umastrings/26_HA018/docs/hanium_인터페이스_확정현황.md

# 인터페이스 확정 현황

> 팀 간 접점(프로토콜·치수·극성·포트)이 지금 어디까지 정해졌는지 한곳에 모은 문서.
> **"이거 정해졌나?" 싶을 때 여기부터 보면 된다.**
> 최종 갱신: 2026-08-15 (구동계 실측값 8/13 반영)

---

## ✅ 확정된 것

| 항목 | 값 | 근거 |
|---|---|---|
| **시리얼 프로토콜** | `<E,c1..c4>` 25Hz / `<M,pwm1..4>` −255~255 50Hz | 핸드오프 §2 ↔ 펌웨어 일치 확인 |
| 휠 순서 | M1(앞좌/FL) · M2(뒤좌/RL) · M3(뒤우/RR) · M4(앞우/FR) | 양측 동일 |
| baud | 115200 | — |
| **PWM 스케일** | 이중 적용 없음. 젯슨이 최종 PWM(−255~255)을 그대로 전송 | `QGPMaker_MotorShield.cpp` `run()` 에서 `_speed*16` 1회만 (PCA9685 12bit) |
| **펌웨어 워치독** | `CMD_TIMEOUT_MS = 300`. 코스팅 감속 곡선 기준 판정 → 300ms에 정지 확인 | `smart_upcare_uno.ino` · 8/13 실측 |
| **젯슨 워치독** | `cmd_timeout 0.3s` + `enc_timeout 0.2s` (엔코더 업링크 끊기면 폐루프 정지·적분 리셋) | 8/13 추가 |
| **속도 제어 위치** | 젯슨 (FF+PI). UNO 는 개루프, PID 없음 | 아두이노 통합 회신 §5 |
| **UNO 포트** | `/dev/ttyCH341USB0` (CH340 클론, WCH 드라이버 필요) | 아두이노 통합 회신 §6-1 |
| **모터 극성** | `wheel_sign: [-1, -1, 1, 1]` — 좌측 2바퀴(M1·M2) 배선 반대 | 8/13 실측 (구동팀 §6-2는 우측이라 했으나 실측은 좌측) |
| **엔코더 극성** | `enc_sign: [1, 1, 1, 1]` — M1·M2는 모터·엔코더 극성이 실제로 달라 분리 설계가 필요함이 확인됨 | 8/13 실측 |
| **구동 파라미터 (무부하)** | `ff_gain 15.0` · `deadband_pwm 25` · `max_wheel_omega 8.0` | 8/13 무부하 계단입력 실측 · 부하 재측정 예정 |
| **ESP32 대수** | 2대 확보 (#1 IMU+리프트 / #2 섀시폭) | 8/7 |
| **섀시 치수** | 펼침 394×492 / 축소 280×378 mm | 7/29 STEP 실측 |
| 트랙폭 / 휠베이스 | 206.99 / 192.05 mm (바퀴 축 중심 간) | 7/29 STEP 실측 |
| 휠 지름 | 80.29 mm (CAD 외경) | 7/29 STEP 실측 · 하중 보정 필요 |
| **라이다 마운트** | 전용 고정 구조물. 가변폭과 분리 → `base_link→lidar_link` 상수 | 7/27 결정 |
| 감속비 | 90:1 → CPR 4,320 pulse/rev (4320 확인) | 8/13 enc 실측 |

---

## ⏳ 아직 정해지지 않은 것

### 🔴 리프트 명령 다운링크

젯슨에서 리프트로 **"이 높이로 올려줘"** 를 보내는 패킷이 없다.
현재는 현재높이 업링크(`<I,...>` 의 `lift_mm`)만 있다.

제안 형태:

```
젯슨 → ESP32 #1    <L,target_mm>\n
    target_mm : 목표 높이 [mm]
    예)  <L,700.0>
```

젯슨 쪽은 이미 `/lift_cmd_mm` 로 목표높이를 발행 중이라, 포맷만 정해지면 바로 연결된다.
**이게 정해져야 데모 시퀀스(침상 정지 → 리프트 상승 → 회전 → 퇴출)가 완주된다.**

같이 정할 것 —

- `lift_mm` 기준면: 완전히 접힌 상태가 0인지, 다른 값인지
- 도달 판정: `lift_mm` 수렴으로 볼지, 별도 완료 신호를 둘지
- 가동 범위: 100~740mm 유지되는지

### 🟡 3D 프린트 완료 예정일

일정 역산 기준점.

---

## 📐 조립 후 (부하 상태) 재측정할 값

위 구동 파라미터는 **무부하(바퀴 공중)** 기준 8/13 실측값이다. 조립 후 부하가 걸리면 달라지므로 다시 잡는다.
절차와 도구는 [`hanium_구동계_캘리브레이션_절차_0807.md`](hanium_구동계_캘리브레이션_절차_0807.md).

| 값 | 무부하 (8/13) | 부하 상태에서 확정할 것 |
|---|---|---|
| `ff_gain` | 15.0 | 부하 시 같은 PWM에 각속도가 떨어짐 → 재측정 |
| `deadband_pwm` | 25 | 바닥 마찰 + 로봇 무게로 커짐 → 재측정 |
| `max_wheel_omega` | 8.0 | 부하 최대속도 재확인 |
| 휠 유효반경 | 0.040145 m (CAD, 🔴 미확정) | 직진 2m 실측 vs 오도메트리로 역산 |
| 트랙폭 / 휠베이스 | 206.99 / 192.05 mm (STEP) | 제자리 90°/180° 회전으로 검증 |
| `wheel_sign` / `enc_sign` | 확정 (위 ✅) | 배선을 다시 했을 때만 재확인 |

---

## 🔗 정해지면 반영되는 곳

접점이 확정될 때 어느 파일이 바뀌는지. **바꾸기 전에 상대 팀에 알린다.**

| 확정 항목 | 반영 위치 |
|---|---|
| 리프트 패킷 | `serial_protocol.py` 다운링크 추가 + `serial_bridge_node.py` `/lift_cmd_mm` 구독 |
| `lift_mm` 기준면 | `lift_tf_node.py` 의 `lift_mm_is_absolute` |
| 섀시 최종 치수 | `nav2_care.yaml` local/global footprint |
| 라이다 높이 | `smart_upcare.urdf.xacro` 의 `lidar_link` |
| 캘리브레이션 값 | `serial_bridge_node.py` 파라미터 기본값 |
| ESP32 #2 연결 | `robot_bringup.launch.py` 의 `enable_esp2` |

> `enable_esp2` 는 당분간 `false` 유지. ESP32 #2 펌웨어가 아직 없고,
> 포트 고정 경로(`by-id`/`by-path`)가 안 정해진 상태에서 켜두면 엉뚱한 장치를 열 수 있다.

---

## 미해결 기술 이슈

코드 검토에서 나온 것 중 팀 간 조율이 필요한 항목. 상세는
[`hanium_실차전_코드점검_0807.md`](hanium_실차전_코드점검_0807.md).

| 항목 | 상태 |
|---|---|
| `local_costmap` footprint 가 시뮬용 축소값(0.34×0.30)으로 남아 있음 | 실물 치수로 복원 필요 |
| `/scan_depth`(D415) 를 Nav2·Collision Monitor 가 안 씀 | 배선 미완 |
| `QGPMaker_Encoder.h` 의 `read()` 인터럽트 미보호 → 카운트 튐 가능 | 캘리브레이션에서 실측 확인 후 판단 |
