umastrings/26_HA018/docs/hanium_하드웨어_완성_로드맵_체크리스트.md

# hanium_하드웨어 완성 로드맵 체크리스트 (7/27 → 8/8)

> **작성**: 구영인 (자율주행/퍼셉션)
> **기준일**: 2026-07-27 · **하드웨어 조립 완료 목표**: 8/8 (D-12)
> **관련 문서**: `hanium_알고리즘_명세서_자율주행.md` (v1.2), `05_시뮬레이션_셋업_체크리스트.md` (v2.0), `hanium_최종결론_백업.md` (v1.2)

> **📌 7/27 갱신 — §4 ROS 파일 초안 전부 완성 (B안 재편)**
> `~/hanium_ws`에 §4 파일 전부 초안 작성·정적 검증 완료. serial_bridge를 **3-MCU + IK/FK 통합 + FF/PI 폐루프 + 300ms 워치독**으로 재편(B안). 중복된 `mecanum_ik_node`/`mecanum_odom_node`는 브리지 통합으로 삭제. `laser_filter.yaml`도 no-op 템플릿으로 선작성.
> 검증(샌드박스): 폐루프 수렴오차 0.0099 rad/s · 프로토콜 왕복 · YAML/xacro 파싱 · entry_point · 전체 컴파일 통과. **`colcon build`는 VM/젯슨에서 필요(ROS2 미설치 환경).**
> 남은 실물 의존: ①리프트 명령 다운링크(→ESP32) 프로토콜 미정 §6 ②`lift_mm` 기준면 §6 ③ESP32 대수(`enable_esp2`) ④Gazebo 스폰 롤오버·prismatic 처짐 확인.

## 오늘 확인된 것

| 항목 | 상태 |
|---|---|
| 메카넘휠 구동 | ✅ 정상 회전 확인 |
| RPLIDAR A2M12 | ✅ 젯슨 연결 → RViz2에서 LaserScan 출력 확인 |
| RealSense D415 | ✅ 젯슨 연결 → 영상 출력 확인 |
| 섀시 (7/27 CAD 공유) | 🟡 젯슨 중앙 공간 확보, 곡면 커버 수정 완료 → 3D 프린트 대기 |
| 라이다 마운트 | ✅ **전용 고정 구조물로 확정** (7/27) — 가변폭과 분리됨. 높이만 미정 |
| 가변폭 방식 | ✅ **대각선 45° 수축** — 가로·세로 델타 모두 114mm. 모서리 하나가 약 81mm 이동 |

---

## 0. 계획 점검 — 생각한 두 가지에 대한 판단

| 생각한 것 | 판단 | 이유 |
|---|---|---|
| **가상 월드 구성해서 시뮬레이션** | ⚠️ **이미 완료된 항목** | `care_facility.world`(복도 8m×1.2m + 침상 3개) 제작 + `care_map.pgm/.yaml` 저장이 7/23에 끝남. 지금 필요한 건 새 월드가 아니라 **그 월드 위에서 Collision Monitor 통합 → Nav2 재튜닝 → 데모 시퀀스 완주** |
| **하드웨어 완성 시 필요한 ROS 파일/코드 작성** | ✅ **맞음. 가장 중요** | 단, "완성 **시**"가 아니라 **지금 미리** 써야 함. 조립 끝나고 코드 시작하면 8월 말 데모 영상 마감 못 맞춤. §4 파일 목록 참고 |
| *(빠짐)* **3D 프린트 발주 전 치수·마운트 확정** | 🔴 **최우선 · 되돌릴 수 없는 마감** | 프린트 후엔 못 바꿈. LiDAR 마운트 위치·카메라 오프셋·가변폭 치수가 URDF·footprint·TF 전부에 직결 |
| *(빠짐)* **조립 없이 지금 가능한 실물 캘리브레이션** | 🔴 **시간 벌기** | 바퀴+엔코더+UNO만 있으면 감속비 실측·`wheel_sign`·PWM↔rad/s 맵 전부 가능. 조립 후로 미루면 그 주에 몰림 |
| *(빠짐)* **젯슨 소프트웨어 스택 완비** | 🟡 | ROS2/slam_toolbox/Nav2/realsense 빌드는 섀시와 무관. 조립 당일에 apt 의존성 씨름하면 하루 날아감 |
| *(빠짐)* **rosbag 실물 스캔 녹화** | 🟡 **이득 큼** | 라이다 이미 살아있음 → 복도 한 바퀴 `/scan` 녹화해두면 **조립 전에도 실물 데이터로 SLAM 파라미터 튜닝 가능**. 시뮬 튜닝값의 실물 유효성을 미리 확인 |

**한 줄 요약**: 방향은 맞는데 우선순위가 뒤집혀 있음. 지금 제일 급한 건 시뮬이 아니라 **① 3D 프린트 전에 섀시팀에 못 박을 것들**과 **② 조립 없이 지금 뽑아낼 수 있는 실물 데이터**임.

---

## 1. 🔴 3D 프린트 발주 전에 확정할 것 (마감: 프린트 발주일)

이 섹션은 **프린트가 시작되면 되돌릴 수 없음**. 다른 어떤 작업보다 먼저.

### 1-1. 섀시팀에서 받아야 할 값

- [ ] **STEP(또는 STL) 파일 확보** ★ 최우선 — 렌더 이미지로는 판단 불가. 받으면 아래 치수 대부분을 FreeCAD로 직접 실측 가능하므로 왕복 질문이 줄어듦
- [ ] 수정된 CAD 기준 **트랙폭 / 휠베이스** (바퀴 축 중심 간 실측치)
  - 기존 사용값: 트랙폭 250mm(스펙) vs 244.4mm(FreeCAD 실측), 휠베이스 186mm → 변경 여부 확인
- [ ] **가변폭 범위** 재확인 (기존: 가로 280~394mm / 세로 378~492mm)
  - 7/27 확인: **대각선 45° 수축**. 가로 394→280, 세로 492→378로 델타가 둘 다 114mm로 동일 → 모서리 하나가 x·y 각각 57mm, 대각선 약 81mm 이동
- [ ] **Nav2 footprint 재확정** (기존 0.394 × 0.492m) — 폭이 바뀌면 costmap·Collision Monitor 폴리곤 전부 영향
- [ ] **3D 프린트 완료 예정일** — 8/8 역산의 기준점
- [ ] 섀시 대략 질량 (URDF inertia 근사용)

### 1-2. LiDAR 마운트 — 7/27 갱신 ✅ 큰 방향 확정

**해소됨**: 라이다 **전용 고정 구조물**을 두기로 확정. 가변폭 브래킷과 분리되므로 `base_link → lidar_link`가 상수로 유지됨.

파생 효과 세 가지 — Dynamic TF로 폭을 보상할 필요가 없어졌고, **ESP32 #2가 비블로킹 상태 그대로 유지**되며(로컬라이제이션이 섀시폭 데이터에 묶이지 않음), **Slamtec C1 전환 검토가 불필요**해짐.

> 만약 라이다가 가변폭 브래킷에 붙었다면 대각선 수축으로 주행 중 약 81mm 이동했을 것. 1.2m 복도에서 8cm면 AMCL이 흔들리고, 하필 폭을 줄이는 순간(= 가장 좁은 곳)에 가장 크게 틀어졌을 구조. **이 판단은 심사에서 설명할 가치가 있음.**

**남은 결정은 사실상 "높이" 하나.**

- [ ] **구조물 높이 확정** — 기준: **최소폭 상태**에서 네 모서리 브래킷보다 스캔면이 위일 것
  - 대각선 수축이라 폭을 줄이면 브래킷이 라이다 쪽으로 x·y 각각 57mm씩 접근. **최대폭 기준으로 정하면 폭을 줄였을 때 전방 대각선 4방향에 사각지대**가 생김 — 제일 안 좋은 자리
- [ ] **높이 상한 검토** — 25~30cm 초과 시 재검토 (기존 명세서 값: 지면 기준 17.5cm)
  - 2D 라이다는 한 평면만 봄 → 너무 높으면 문턱·사람 발·휠체어 발판 같은 저상 장애물을 전부 놓침. 케어시설에서는 실질 위험 요소
- [ ] **강성·진동 요구 전달** — 짧고 굵게 + 보강 리브
  - 메카넘 롤러 주행 진동 + 라이다 자체 600rpm 불균형 → 얇고 긴 기둥은 공진 → 스캔 흔들림이 scan matching 품질로 직결. 3D 프린트라 특히 취약
- [ ] **마운트 나사 제한 전달** — 바닥 M3 4개, **길이 4mm 초과 금지**
  - 초과 시 내부 모듈 손상 (데이터시트 명시 경고). 플레이트 두께 설계에 직결
- [ ] 아래에서 받치는 형태 유지 확인 — 스캔면 주변에 지지 기둥이 없어야 함 (현재 방향 맞음)
- [ ] 라이다 케이블이 구조물 타고 내려가는 경로 확보
- [ ] **STEP 확보 후 직접 검증** — 스캔면 높이로 단면을 잘라 바퀴 브래킷·후방 곡면 커버·리프트 베이스의 간섭 각도 측정 (최소폭·최대폭 두 상태 모두)

### 1-3. 나머지 센서 장착 요건

- [ ] **BNO055 IMU**: 모터 드라이버·배터리 케이블에서 최대한 이격 (지자기 센서 내장 → yaw 흔들림). REP-103 방향(X=전방, Y=좌, Z=상)
- [ ] **D415 카메라**: 리프트 상단, 아래로 **15~30° 고정 틸트** (조절식 비채택 — TF 변수 증가)
- [ ] **USB-C 케이블 배선**: 리프트 100~740mm 상하 이동 추종. 여유 길이 + 케이블 체인 경로. 짧으면 탈락, 길면 기구 간섭
- [ ] **센서 좌표 실측용 기준면 정의**: 조립 후 `lidar_link` / `imu_link` / `lift_top → camera_link`(xyz + 틸트각)를 줄자로 잴 수 있게 기준점 합의
- [ ] USB 허브·젯슨·배터리 배치 공간 확보 (허브 4포트 + 케이블 5가닥)

### 1-4. 지연 대비

- [ ] **플랜 B**: 3D 프린트가 8/5을 넘기면 → 아크릴판/알루미늄 프로파일 임시 섀시에 바퀴+라이다만 얹어 **주행·SLAM 검증만이라도** 선행. 리프트·가변폭은 최종 섀시로
- [ ] 프린트 실패(휨/치수 오차) 대비 여유일 1~2일 확보

---

## 2. 🔴 지금 젯슨에서 (섀시 없이 가능)

### 2-1. 구동계 캘리브레이션 — 바퀴 공중 상태

- [ ] **감속비 30:1 vs 90:1 실측** — 바퀴 손으로 1회전 시 엔코더 카운트 확인
  - 4,320 → 90:1 / 1,440 → 30:1. `distance_per_pulse`가 **3배 차이** → 오도메트리 스케일 직결
- [ ] **`wheel_sign` 검증** — 바퀴별 개별 구동, 전진 시 4바퀴 모두 카운트 증가하는지 (`[1,1,1,1]` 가정 확인)
- [ ] **PWM↔rad/s 피드포워드 맵 + 데드밴드** — Setspeed 3→5→8→12 계단 인가, 바퀴별 실측 rad/s 기록
- [ ] PI 게인 초기값 세팅 (linorobot2_hardware 참고: Kp 0.6 / Ki 0.8), D항 생략
- [ ] 시리얼 브리지 **실물 포트 검증** — socat 가상포트 → `/dev/serial/by-id/` 고정 경로로 전환
- [ ] 300ms 워치독 동작 확인 (명령 끊기면 정지)

### 2-2. 센서 실물 확인 (이어서)

- [ ] **D415 USB3 링크 해결** — 현재 USB2.1로 잡히는 상태
  - `lsusb -t`로 5000M 확인, USB3 대응 Type-C 케이블(정품/데이터 지원), 젯슨 USB3 포트 직결(허브 금지)
  - 한이음 트랙은 USB2 저해상도(`480x270x6` depth / `424x240x6` color)로 진행 가능하지만, **연구 트랙 IR 스테레오 동시 스트리밍의 블로커**
- [ ] A2M12 `frame_id:=lidar_link`, `serial_baudrate:=256000` 명시 확인
- [ ] **자기 몸체 각도 마스킹 필요 여부 판단** — 마운트 확정 후 `laser_filters`의 angular bounds filter 적용 검토
- [ ] `depthimage_to_laserscan` 연결 → D415 depth를 Nav2 costmap에 투입
- [ ] ESP32 #1 → BNO055 스트림 확인 (yaw, gyro_z / CCW 회전 시 양수인지)

### 2-3. rosbag 선행 녹화 ★ 조립 전 최대 이득

- [ ] 라이다를 임시 판/손수레에 올려 **실제 복도 한 바퀴 주행하며 `/scan` 녹화**
  - `ros2 bag record /scan /tf /tf_static`
- [ ] 녹화 bag으로 **slam_toolbox 실물 파라미터 튜닝** (조립 없이 가능)
  - 시뮬 검증값(`inflation_radius` 0.25 / `max_vel_x` 0.3)이 실물 스캔 밀도에서도 유효한지 확인
- [ ] D415 RGB+depth도 같이 녹화 → 연구 트랙 데이터셋 초기분으로 재활용

### 2-4. 젯슨 소프트웨어 스택 완비

- [ ] ROS2 Humble 확인
- [ ] `slam_toolbox` — **libunwind 충돌 순서 그대로 적용**
  `sudo apt --fix-broken install` → `sudo apt install libunwind-dev` → `sudo apt install ros-humble-slam-toolbox`
- [ ] `nav2-bringup`, `navigation2`, `robot-localization`, `xacro`, `robot-state-publisher`
- [ ] `rplidar_ros`
- [ ] `librealsense2` + `realsense2_camera` **소스 빌드** (apt 패키지 대신)
- [ ] `nav2_collision_monitor`, `laser_filters`, `depthimage_to_laserscan`
- [ ] `setuptools==58.2.0` 핀 (Humble Python 패키지 호환)
- [ ] `~/hanium_ws` 워크스페이스 젯슨 이관 후 `colcon build` 통과

---

## 3. 🟡 시뮬 트랙 (VM, 병행 진행)

- [ ] **Collision Monitor 통합** — `stop` 30cm / `slowdown` 50cm 2단 폴리곤, `cmd_vel` → `cmd_vel_smoothed` 체인
- [ ] **케어 월드 기준 Nav2 재튜닝** — ⚠️ **반드시 Collision Monitor 붙인 뒤에.** slowdown 폴리곤이 속도를 깎으므로 순서 바뀌면 튜닝 결과 무효
- [ ] URDF에 A2M12(range 0.2~12, samples 1600) / D415(FOV 1.134rad) 실제 스펙 반영
- [ ] **Dynamic TF prismatic 전환** + **가상 `lift_mm` 퍼블리셔**로 선행 검증 (리프트 하드웨어 안 기다림)
- [ ] Dynamic TF **정량 목표 측정** — `lift_mm` 수신 → TF 갱신 지연 몇 ms / 오차 몇 mm (차별점 ①의 근거 수치)
- [ ] URDF 스폰 롤오버(약 90° 롤) 수정 — 바퀴 collision 실린더 `rpy` 가설 검증. **데모 영상 품질에 직결**
- [ ] `spawn.launch.py` 좌표 하드코딩(line 82) → `DeclareLaunchArgument`
- [ ] **데모 시나리오 전체 시퀀스 시뮬 완주** — 복도 진입 → 침상 옆 정지 → 리프트 상승 → 180° 제자리 회전 → 전진 퇴출
  - ※ 180° 회전 클리어런스: 최대폭 대각선 약 630mm vs 복도 1.2m → 여유 있음. 단 **최소폭(약 470mm)으로 줄인 뒤 회전**하는 시퀀스가 더 안전
- [ ] **시뮬 데모 영상 녹화** — 하드웨어 지연 시 백업 산출물
- [ ] *(후순위)* Nav2 footprint 동적화 검토 — 대각선 수축이라 폭뿐 아니라 길이도 변함. 최소폭 상태(0.280×0.378)에서 최대치 footprint(0.394×0.492)를 그대로 쓰면 costmap이 과도하게 보수적이 되어 **좁은 곳 들어가려고 폭을 줄인 효과가 반감됨**. 실물 주행 안정화 이후 착수

---

## 4. 📝 지금 써둬야 할 ROS 파일 목록

**원칙**: 시뮬/실물 분기는 `use_sim_time`과 launch argument로만. **노드 코드는 동일하게** 유지해야 이관 비용이 0에 수렴함.

| 파일 | 역할 | 지금 가능? |
|---|---|---|
| `smart_upcare_control/serial_bridge_node.py` | 3포트 PySerial 수신 → `/odom_raw`·`/imu/data`·`lift_mm` 발행 / `/cmd_vel_smoothed` 구독 → 메카넘 IK → **속도 폐루프(FF+PI)** → `<M,w1..w4>` 다운링크 / 300ms 워치독 | ✅ socat + 실물 UNO |
| `mecanum_ik.py` | IK/FK (단위테스트 완료분) → 브리지에 통합 | ✅ |
| `lift_tf_node.py` | `lift_mm` → joint_state → prismatic TF 갱신 | ✅ 가상 퍼블리셔 |
| `virtual_lift_publisher.py` | 리프트 하드웨어 없이 `lift_mm` 모사 | ✅ |
| `config/ekf_real.yaml` | 실물용 EKF (`use_sim_time: false`) — 시뮬용과 파일 분리 | ✅ |
| `config/nav2_care.yaml` | 케어 월드/실물 공용 Nav2 파라미터 | ✅ |
| `config/collision_monitor.yaml` | stop 30cm / slowdown 50cm 폴리곤 | ✅ |
| `config/laser_filter.yaml` | 자기 몸체 각도 마스킹 | ✅ 템플릿 작성(각도는 마운트 확정 후 실측) |
| `launch/sensors.launch.py` | rplidar + realsense + depthimage_to_laserscan | ✅ |
| `launch/robot_bringup.launch.py` | sensors + serial_bridge + ekf + robot_state_publisher | ✅ |
| `launch/navigation.launch.py` | nav2 + collision_monitor, `slam:=true/false`로 SLAM↔AMCL 분기 | ✅ |
| `launch/demo_scenario.launch.py` | 웨이포인트 + 리프트 명령 + 회전 시퀀스 | ✅ |
| `urdf/*.xacro` | 섀시 치수·센서 좌표를 **xacro property로 전부 파라미터화** → 실측값만 갈아끼우면 되게 | ✅ |

- [x] 위 파일 중 ✅ 표시 전부 **8/5까지 초안 완성** (조립 전) — **7/27 완료** (B안 재편, 정적 검증 통과)
- [x] 실측이 필요한 값은 **명확한 TODO 주석 + 기본값**으로 남겨서 조립 당일 숫자만 교체 — 완료
- [ ] **VM/젯슨에서 `colcon build` 통과 확인** — 남음 (ROS2 미설치 샌드박스에선 정적 검증까지만)
- [ ] serial_bridge 재편 반영: 신규 `lift_tf_node`/`virtual_lift_publisher`/`demo_scenario_node` 포함, 중복 `mecanum_ik/odom` 삭제됨

---

## 5. 8/8 이후 — 실물 브링업 순서 (이 순서 지킬 것)

1. [ ] 센서 마운트 좌표 실측 → URDF 갱신 → `ros2 run tf2_tools view_frames`로 TF 트리 확인
2. [ ] 바퀴 공중 `wheel_sign`·캘리브레이션 **재확인** (조립 후 부하 달라짐)
3. [ ] 정지 상태에서 `/odom_raw`·`/imu/data`·`/odometry/filtered` hz + 드리프트 확인
4. [ ] **직진 1m 실측 vs 오도메트리** → `distance_per_pulse`(감속비) 최종 검증
5. [ ] **제자리 90°/180° 회전** → IMU yaw 정합 확인
6. [ ] **횡이동(vy) 1m** → 메카넘 정합. 사선으로 밀리면 바퀴별 속도 편차 → PI 게인 재조정
7. [ ] teleop + slam_toolbox로 **실제 복도 맵 생성·저장**
8. [ ] AMCL + Nav2 자율주행 (초기 위치 지정 → 목표점 도달)
9. [ ] Collision Monitor 실물 확인 (사람 손 30cm 접근 → 정지)
10. [ ] 리프트 연동 → Dynamic TF 실물 검증 (지연/오차 측정)
11. [ ] **데모 시나리오 완주 → 촬영**

---

## 6. 팀 확인 대기 (블로킹 순)

| 대상 | 항목 | 시급도 |
|---|---|---|
| **섀시팀** | **STEP(STL) 파일** / 라이다 구조물 **높이** / 프린트 완료 예정일 | 🔴 즉시 |
| **섀시팀** | 라이다 나사 **4mm 초과 금지** + 강성·보강 리브 요구 전달 | 🔴 즉시 |
| ~~섀시팀~~ | ~~LiDAR 마운트 지점 (가변폭 무관 고정부 확보)~~ → **해소 (7/27)** 전용 고정 구조물 확정 | ✅ |
| **구동팀** | **ESP32 실물 2대 확보 여부** — 1대뿐이면 3-MCU 아키텍처 재검토 | 🔴 즉시 |
| 구동팀 | USB 허브 전원 (배터리 구동 시 12V→5V) — **라이다 단독으로 기동 돌입 2.5A**, 벅 컨버터 용량 산정에 반영 | 🟡 |
| 구동팀 | 300ms 워치독 펌웨어 반영 가능 여부 | 🟡 |
| 구동팀 | 리프트 가동 범위 100~740mm 조립 후 재확인 | 🟡 |
| 구동팀 | ESP32 #2(섀시폭) 젯슨 연결 경로 — 비블로킹 | 🟢 |
| 효선 언니 | `lift_mm` 패킷 포맷·식별자 확정 / 리프트 상단판 기준면 | 🟡 |

---

## 7. 일정 (7/27 → 8/8)

| 기간 | 실물 트랙 | 시뮬 트랙 |
|---|---|---|
| **7/27~7/29** | 섀시팀 치수·LiDAR 마운트 확정 요청 · 감속비/`wheel_sign` 실측 · rosbag 녹화 | Collision Monitor 통합 |
| **7/30~8/1** | PWM↔rad/s 캘리브레이션 · 젯슨 스택 완비 · D415 USB3 해결 · **LiDAR 기종 최종 판단(8/1)** | 케어 월드 Nav2 재튜닝 |
| **8/2~8/5** | 시리얼 브리지 실물 검증 · bag 기반 SLAM 튜닝 | Dynamic TF prismatic + 가상 퍼블리셔 · **ROS 파일 초안 전부 완성** |
| **8/6~8/7** | 조립 준비 · 배선 계획 · 실측 절차 리허설 | 데모 시퀀스 시뮬 완주 + 백업 영상 녹화 |
| **8/8** | **조립 완료 → §5 브링업 1~3단계까지** | — |
| 8/9~ | §5 4~11단계 → 데모 촬영 (8월 말 마감 역산) | — |

---

## 8. 리스크 & 대응

| 리스크 | 대응 |
|---|---|
| 3D 프린트 8/5 초과 지연 | 임시 섀시(아크릴/프로파일)로 주행·SLAM만 선행 검증 (§1-4) |
| ~~LiDAR 마운트 지점 확보 실패~~ | **해소 (7/27)** — 전용 고정 구조물 확정. C1 전환 검토 불필요 |
| 라이다 구조물 공진 → 스캔 흔들림 | 짧고 굵게 + 보강 리브. 조립 후 주행 중 `/scan` 안정성 확인, 심하면 방진 와셔·댐퍼 삽입 |
| 폭 축소 시 전방 대각선 사각지대 | 구조물 높이를 **최소폭 상태 기준**으로 산정 (§1-2). STEP 단면으로 사전 검증 |
| ESP32 1대만 있음 | IMU+리프트+섀시폭을 1대에 통합하거나, 섀시폭을 수동/고정으로 강등 |
| D415 USB2 고착 | 한이음 트랙은 USB2 저해상도로 진행 가능. **연구 트랙만 블로킹** — 별도 해결 |
| 조립 후 오도메트리 스케일 오차 | 감속비를 조립 전에 실측해두면 조립 당일 리스크 소거 (§2-1) |
| 데모 영상 마감 압박 | 시뮬 데모 영상을 8/7까지 확보해 백업 (§3) |

---

## 부록: 이 문서와 기존 문서의 관계

- `05_시뮬레이션_셋업_체크리스트.md` — VM 시뮬 환경 구축·명령어 레퍼런스 (변경 없음)
- `hanium_알고리즘_명세서_자율주행.md` — 알고리즘 5블록 설계 근거 (변경 없음)
- **이 문서** — 7/27~8/8 하드웨어 완성 구간의 **실행 순서·우선순위**만 담당
- 조립 후 실측값이 확정되면 → 명세서 v1.3 / 05번 v2.1로 **일괄 반영** (확정된 것만, 한 번에)
