umastrings/26_HA018/maps/my_map.png

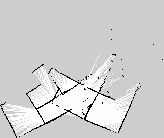
maps/my_map.png
