umastrings/26_HA018/maps/my_map_02.png

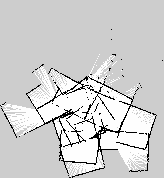
maps/my_map_02.png
