umastrings/26_HA018/maps/my_map_v6_view.png

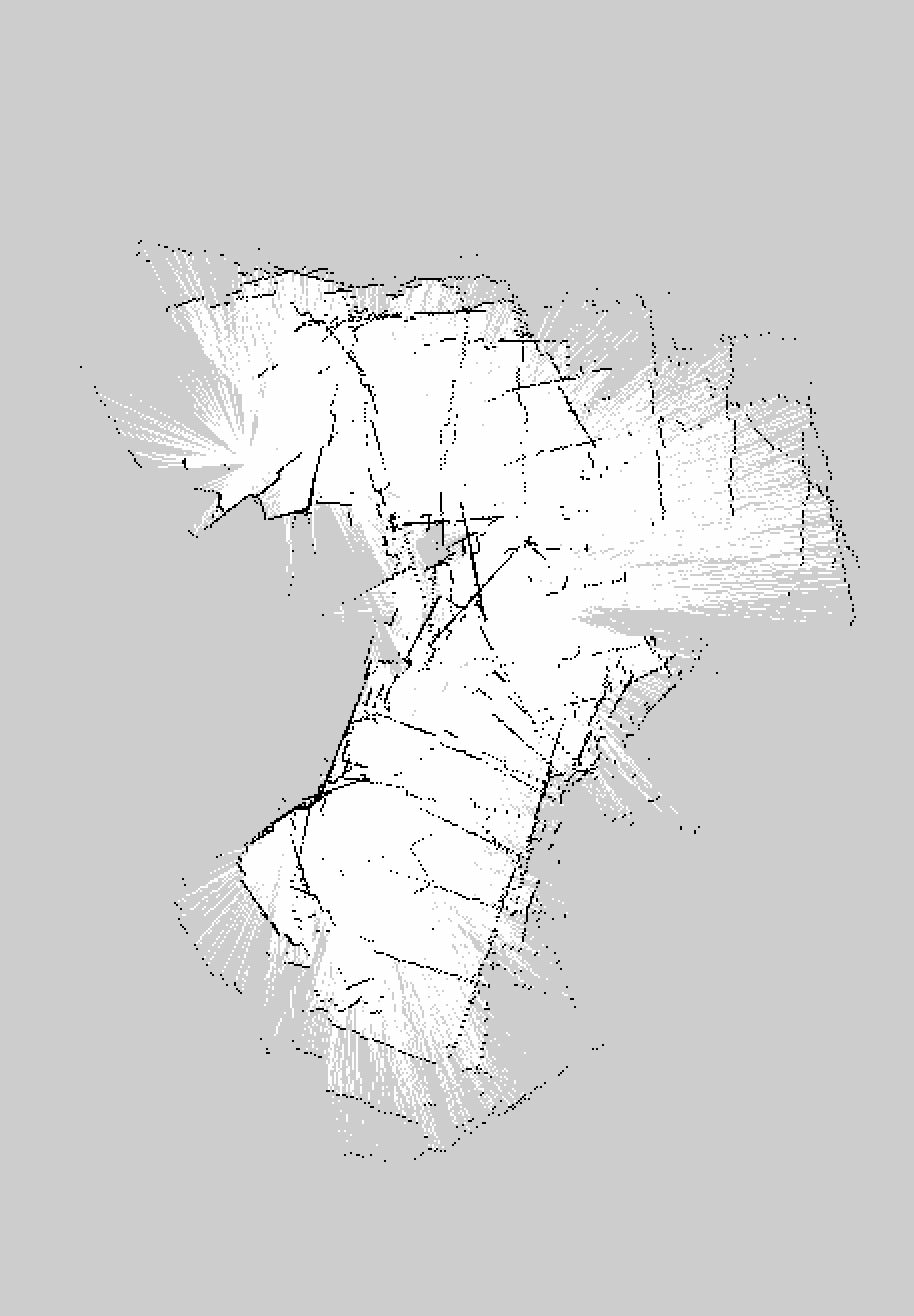
maps/my_map_v6_view.png
