umastrings/26_HA018/smart-upcare-main/src/smart_upcare/worlds/hospital_4bed_verify.txt

==============================================================================
 [1] 정적 박스 상호 겹침 검사
==============================================================================
  박스 38개 / 벽 코너 접합(의도됨) 22건 / 비정상 겹침 0건  -> PASS

==============================================================================
 [2] 로봇 자세별 여유거리 (footprint AABB 기준)
     내접원 0.2255 m / inflation_radius 0.34 m
==============================================================================
  robot_spawn            ( -0.60,  0.00, yaw    0.0deg) 최근접 ns_chair          0.381 m  PASS
  goal_nurse_station     ( -0.70,  0.00, yaw  180.0deg) 최근접 ns_chair          0.375 m  PASS
  goal_corridor_entry    (  1.00,  0.00, yaw    0.0deg) 최근접 cr_wall_n_1       0.374 m  PASS
  goal_room_entry        (  8.60,  0.00, yaw    0.0deg) 최근접 rm_wall_w_n       0.590 m  PASS
  goal_bed_1             ( 10.20,  1.00, yaw   90.0deg) 최근접 bed_1             0.350 m  PASS
  goal_bed_2             ( 12.80,  1.00, yaw   90.0deg) 최근접 bed_2             0.350 m  PASS
  goal_bed_3             ( 10.20, -1.00, yaw  -90.0deg) 최근접 bed_3             0.350 m  PASS
  goal_bed_4             ( 12.80, -1.00, yaw  -90.0deg) 최근접 bed_4             0.350 m  PASS
  결과: 8개 자세 중 문제 0건  -> PASS

==============================================================================
 [3] 실제 기하로 스캔한 통행 유효폭 (y=0 을 포함하는 자유 구간)
==============================================================================
  x= -1.00 간호스테이션 중앙            자유폭  1.60 m (y -1.00~+0.60) 편측여유 0.575 m  PASS
  x=  0.30 복도 입구                자유폭  1.20 m (y -0.60~+0.60) 편측여유 0.374 m  PASS
  x=  2.00 복도 직선부               자유폭  1.20 m (y -0.60~+0.60) 편측여유 0.374 m  PASS
  x=  4.00 알코브 구간               자유폭  1.80 m (y -0.60~+1.20) 편측여유 0.674 m  PASS
  x=  6.00 남측 리세스 구간            자유폭  1.80 m (y -1.20~+0.60) 편측여유 0.674 m  PASS
  x=  7.70 문 앞 확장 구간            자유폭  1.40 m (y -0.70~+0.70) 편측여유 0.474 m  PASS
  x=  7.95 병실 개구부(벽면)           자유폭  1.40 m (y -0.70~+0.70) 편측여유 0.474 m  PASS
  x=  8.60 병실 진입 직후             자유폭  5.00 m (y -2.50~+2.50) 편측여유 2.275 m  PASS
  x= 10.20 Bed1/Bed3 사이         자유폭  3.20 m (y -1.60~+1.60) 편측여유 1.374 m  PASS
  x= 11.50 커튼 구간                자유폭  3.20 m (y -1.60~+1.60) 편측여유 1.374 m  PASS
  x= 12.80 Bed2/Bed4 사이         자유폭  3.20 m (y -1.60~+1.60) 편측여유 1.374 m  PASS
  x= 14.20 병실 동단                자유폭  4.16 m (y -2.08~+2.08) 편측여유 1.854 m  PASS
  결과: 12개 단면 중 문제 0건  -> PASS
  침상 간 간격(커튼 두께 0.08 포함) 0.60 m

==============================================================================
 [4] LiDAR 가시성 (스캔 평면 z=0.175 m)
==============================================================================
  스캔 평면보다 낮아 지도에 안 잡히는 물체: 없음 (전부 가시)

==============================================================================
 [5] 데모 장애물 배치 시 잔여 통행폭
==============================================================================
  복도-알코브구간(회피)       ( 4.00,-0.30)  최광 자유폭  1.30 m  편측여유 0.424 m  -> 회피 가능 (여유 충분)
  복도-직선부(정지)         ( 2.00,-0.30)  최광 자유폭  0.70 m  편측여유 0.124 m  -> 통과 불가 -> 정지/대기 데모용
  병실 중앙통로(회피)        (11.50, 0.00)  최광 자유폭  1.40 m  편측여유 0.474 m  -> 회피 가능 (여유 충분)
  병실 출입구 앞(회피)       ( 8.90, 0.35)  최광 자유폭  2.20 m  편측여유 0.874 m  -> 회피 가능 (여유 충분)
