umastrings/26_HA018/arduino/smart_upcare_uno/QGPMaker_Encoder.h

/******************************************************************

 It will only work with http://www.7gp.cn
 
 ******************************************************************/

#ifndef Encoder_h_
#define Encoder_h_
#include "PinChangeInterrupt.h"

typedef struct
{
  uint8_t pin1;
  uint8_t pin2;
  uint8_t state;
  int32_t position;
} QGPMakerEncoder_internal_state_t;

static QGPMakerEncoder_internal_state_t *interruptArgs[4]; //ENCODER_ARGLIST_SIZE

class QGPMaker_Encoder
{
  //  public:
  //
public:
  QGPMaker_Encoder(uint8_t num)
  {
    if (num > 4)
      return;
    num--;
    int pin1, pin2;
    if (num == 0)
    {
      pin1 = 8;
      pin2 = 9;
    }
    else if (num == 1)
    {
      pin1 = 6;
      pin2 = 7;
    }
    else if (num == 2)
    {
      pin1 = 2;
      pin2 = 3;
    }
    else if (num == 3)
    {
      pin1 = 4;
      pin2 = 5;
    }

#ifdef INPUT_PULLUP
    pinMode(pin1, INPUT_PULLUP);
    pinMode(pin2, INPUT_PULLUP);
#else
    pinMode(pin1, INPUT);
    digitalWrite(pin1, HIGH);
    pinMode(pin2, INPUT);
    digitalWrite(pin2, HIGH);
#endif
    counts_per_rev_ = 4320;
    encoder.pin1 = pin1;
    encoder.pin2 = pin2;
    encoder.position = 0;

    delayMicroseconds(2000);
    encoder.state = 0;

    attach_change_interrupt(pin1, &encoder);
    attach_change_interrupt(pin2, &encoder);
  }

   QGPMaker_Encoder(uint8_t num,int counts_per_rev)
  {
    if (num > 4)
      return;
    num--;
    int pin1, pin2;
    if (num == 0)
    {
      pin1 = 8;
      pin2 = 9;
    }
    else if (num == 1)
    {
      pin1 = 6;
      pin2 = 7;
    }
    else if (num == 2)
    {
      pin1 = 3;
      pin2 = 2;
    }
    else if (num == 3)
    {
      pin1 = 5;
      pin2 = 4;
    }

#ifdef INPUT_PULLUP
    pinMode(pin1, INPUT_PULLUP);
    pinMode(pin2, INPUT_PULLUP);
#else
    pinMode(pin1, INPUT);
    digitalWrite(pin1, HIGH);
    pinMode(pin2, INPUT);
    digitalWrite(pin2, HIGH);
#endif
    counts_per_rev_ = counts_per_rev;
    encoder.pin1 = pin1;
    encoder.pin2 = pin2;
    encoder.position = 0;

    delayMicroseconds(2000);
    encoder.state = 0;

    attach_change_interrupt(pin1, &encoder);
    attach_change_interrupt(pin2, &encoder);
  }

  QGPMaker_Encoder(uint8_t pin1, uint8_t pin2,int counts_per_rev)
  {
#ifdef INPUT_PULLUP
    pinMode(pin1, INPUT_PULLUP);
    pinMode(pin2, INPUT_PULLUP);
#else
    pinMode(pin1, INPUT);
    digitalWrite(pin1, HIGH);
    pinMode(pin2, INPUT);
    digitalWrite(pin2, HIGH);
#endif
    counts_per_rev_ = counts_per_rev;
    encoder.pin1 = pin1;
    encoder.pin2 = pin2;
    encoder.position = 0;
    // allow time for a passive R-C filter to charge
    // through the pullup resistors, before reading
    // the initial state
    delayMicroseconds(2000);
    encoder.state = 0;

    attach_change_interrupt(pin1, &encoder);
    attach_change_interrupt(pin2, &encoder);
  }

  inline int32_t readAndReset()
  {
    int32_t ret = encoder.position;
    encoder.position = 0;
    return ret;
  }

  inline int32_t read()
  {
    return encoder.position;
  }
  inline void write(int32_t p)
  {
    encoder.position = p;
  }

  int getRPM()
  {
    long encoder_ticks = read();
    //this function calculates the motor's RPM based on encoder ticks and delta time
    unsigned long current_time = millis();
    unsigned long dt = current_time - prev_update_time_;

    //convert the time from milliseconds to minutes
    double dtm = (double)dt / 60000;
    double delta_ticks = encoder_ticks - prev_encoder_ticks_;

    //calculate wheel's speed (RPM)

    prev_update_time_ = current_time;
    prev_encoder_ticks_ = encoder_ticks;

    return (delta_ticks / counts_per_rev_) / dtm;
  }

public:
  // update() is not meant to be called from outside Encoder,
  // but it is public to allow static interrupt routines.
  // DO NOT call update() directly from sketches.
  static void update(QGPMakerEncoder_internal_state_t *arg)
  {
    uint8_t p1val = digitalRead(arg->pin1);
    uint8_t p2val = digitalRead(arg->pin2);
    uint8_t state = arg->state & 3;
    if (p1val)
      state |= 4;
    if (p2val)
      state |= 8;
    arg->state = (state >> 2);
    switch (state)
    {
    case 1:
    case 7:
    case 8:
    case 14:
      arg->position++;
      return;
    case 2:
    case 4:
    case 11:
    case 13:
      arg->position--;
      return;
    case 3:
    case 12:
      arg->position += 2;
      return;
    case 6:
    case 9:
      arg->position -= 2;
      return;
    }
  }

private:
	int counts_per_rev_;
	unsigned long prev_update_time_;
    long prev_encoder_ticks_;
  QGPMakerEncoder_internal_state_t encoder;

  static uint8_t attach_change_interrupt(uint8_t pin, QGPMakerEncoder_internal_state_t *state)
  {
    switch (pin)
    {
    case 2:
    case 3:
      interruptArgs[0] = state;
      attachPCINT(digitalPinToPCINT(pin), isr0, CHANGE);
      break;
    case 4:
    case 5:
      interruptArgs[1] = state;
      attachPCINT(digitalPinToPCINT(pin), isr1, CHANGE);
      break;
    case 6:
    case 7:
      interruptArgs[2] = state;
      attachPCINT(digitalPinToPCINT(pin), isr2, CHANGE);
      break;
    case 8:
    case 9:
      interruptArgs[3] = state;
      attachPCINT(digitalPinToPCINT(pin), isr3, CHANGE);
      break;
    default:
      return 0;
    }
    return 1;
  }
  static void isr0(void)
  {
    update(interruptArgs[0]);
  }
  static void isr1(void)
  {
    update(interruptArgs[1]);
  }
  static void isr2(void)
  {
    update(interruptArgs[2]);
  }
  static void isr3(void)
  {
    update(interruptArgs[3]);
  }
};

#endif
