umastrings/26_HA018/(commit log)

2026-09-02 update Arduino
2026-10-29 smart-upcare 최신 코드
    [demo_box.sdf, demo_wheelchair.sdf, hospital_4bed_coords.csv, smart_upcare.urdf.xacro]
